cezarywawrzyniak/bt_vehicle/README.md

# bt_vehicle
Bluetooth controlled vehicle with crash protection project using ATmega328p. 
Made from scratch and controlled by phone using external app. One of my first attempts at soldering. 

Extensive documentation in polish available in pdf.

Videos:

- https://youtu.be/JMrRTvOXGKw
- https://youtu.be/ug8wEGdJlN4
